wontothree/cart-pole/README.md

# Propopropositional Integral Derivative and Nonlinear Model Predictive Control in Cart Pole

## Sinulation Result

cart_pole

time-response

## Physical Result

Watch the video (https://www.youtube.com/shorts/Vz5JtkAQwwo)

# Physical Specifications

- mass of cart : 0.123 kg (122.61g)
- length of cart : 0.045m (4.5cm)
- mass of pole : 0.089 kg (88.68g)
- length of pole : 0.4m (40cm)
- inertia of pole : 0.004 746 kg m^2
- length of rail (linear guide) : 0.72m (72cm)
- maximum magnitude of force : 1.2 N

## Materials

|Name|Product|Price|
|---|---|---|
|Stepper Motor|[KH42JM2-901](https://www.devicemart.co.kr/goods/view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)|27,000 won|
|Stepper Motor Driver|[AM-CS2P](https://www.devicemart.co.kr/goods/view?no=6773)|25,000 won|
|Absolute Rotary Encoder|[EN25-Absolute](https://www.devicemart.co.kr/goods/view?no=15454627)|75,000 won|
|End Stop|[Photo Interrupter Sensor](https://smartstore.naver.com/misoparts/products/5263638196?)|300 won|
|Processor|[Raspberry Pi Pico 1](https://www.devicemart.co.kr/goods/view?no=14021609&src=raspberrypi)|6,400 won|
||||
|Cedar Wooden plank||28,000 won|
|Linear Guide||45,913 won|
|Wooden Rod||2,800 won|
|Shaft Holder||7,260 won|
|Timing Pulley||1,500 won|
|Timing Idler||900 won|
|Timing Belt||1,412 won|
|||
|Sheet Metal (Aluminum)||130,000 won|
