wontothree/cart-pole/firmware/README.md

# Getting Started

contact devcontainer

```bash
build
```

boot and rest Raspberry Pi Pico

copy and paste 'stepper_control.uf2' in build to 'RPI-RP2'
