wontothree/cart-pole/control/README.md

# Nonlinear Model Predictive Control vs Deep Reinforcement Learning

[Nonlinear Model Predictive Control](https://wontothree.github.io/cartpole/mpc/)

# Control Sampling Period

- Measurement period of rotary absolute encoder : 10ms (100Hz)
- Serial communication period : 8 ~ 15 ms
- Control sampling period : 50ms (20Hz)

# NMPC Dependencies

[CasADi](https://web.casadi.org/)

```bash
pip install casadi
```
