wontothree/cart-pole/3d-modeling/linear_guide_base.step

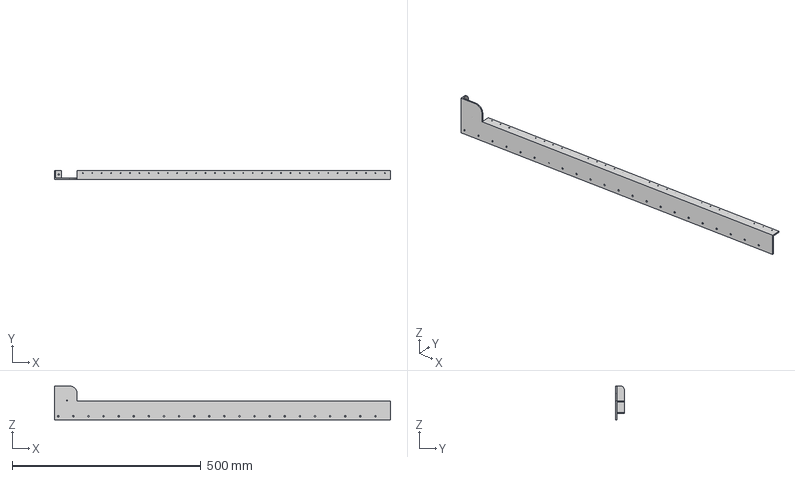
[picture p1: CAD file, 2024-12-08]
3d-modeling/linear_guide_base.step
890.0 x 23.0 x 90.0 mm
