wontothree/cart-pole/3d-modeling/inverted_pendulum.step

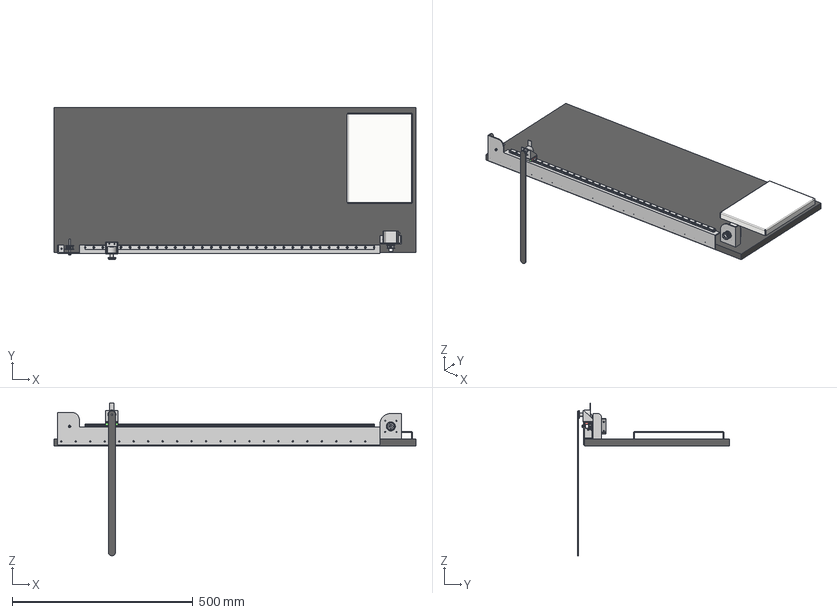
[picture p2: CAD file, 2024-12-08]
3d-modeling/inverted_pendulum.step
1000.0 x 419.6 x 421.5 mm
1000*400_Base
LZE01-MGN12C-800-N-Z0_1
LZE01-MGN12C-N-Z0_2
빵판
linear_guide_base
motor_bracket
stepper_motor
wood_stick
30T_timing_pulley
M4x40
30T_timing_idler
encoder_bracket
rotary_encoder
shaft_coupler
endstop_slot
