wontothree/cart-pole/3d-modeling/motor_bracket.step

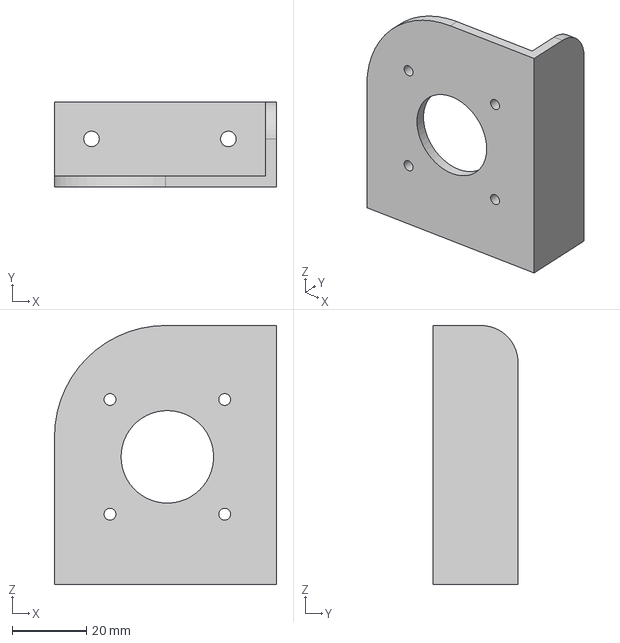
[picture p3: CAD file, 2024-12-08]
3d-modeling/motor_bracket.step
60.0 x 23.0 x 70.0 mm
