wontothree/cart-pole/(list of files, cad)

Other CAD files:
3d-modeling/linear_guide_base.dwg
3d-modeling/linear_guide_base.dxf
3d-modeling/motor_bracket.dwg
3d-modeling/motor_bracket.dxf
