wontothree/cart-pole/control/nmpc/cartpole_nmpc_ver3.py

import numpy as np
import casadi
import matplotlib.pyplot as plt

from mpc import MPC

class CartPoleNMPC(MPC):
    def __init__(self):
        super().__init__(state_dim=4, control_dim=1, prediction_horizon=20, control_sampling_time=0.1)

        # System parameters
        self.gravity = 9.81
        self.cart_mass = 0.123
        self.pole_mass = 0.089
        self.pole_length = 0.4

        # State and control variables
        self.state = casadi.SX.sym("state", self.state_dim)
        self.control = casadi.SX.sym("control", self.control_dim)

        # Cost function weights
        self.Q = casadi.diag([1, 10, 0.0001, 0.0001])
        self.Q_f = casadi.diag([1, 10, 0.0001, 0.0001])
        self.R = casadi.diag([0.1])

        # Constraints
        self.state_lower_bound = [-0.36, -np.inf, -np.inf, -np.inf]
        self.state_upper_bound = [0.36, np.inf, np.inf, np.inf]
        self.control_lower_bound = [-10]
        self.control_upper_bound = [10]

        # number of optimization variables
        self.total_variables = (self.prediction_horizon + 1) * self.state_dim + self.prediction_horizon * self.control_dim

    def define_dynamic_model(self):
        # constant parameter
        g = self.gravity
        M = self.cart_mass
        m = self.pole_mass
        L = self.pole_length

        # state variables
        x = self.state[0]
        theta = self.state[1]
        x_dot = self.state[2]
        theta_dot = self.state[3]

        # control input variable
        F = self.control[0]

        sin = casadi.sin(theta)
        cos = casadi.cos(theta)
        common = M + m * sin**2

        # dynamics
        x_ddot = (m * g * sin * cos - m * L / 2 * sin * theta_dot**2 + F) / common
        theta_ddot = (- m * L / 2 * sin * cos * theta_dot**2 + (M + m) * g * sin + F * cos) / (L / 2 * common)

        states_dot = casadi.vertcat(x_dot, theta_dot, x_ddot, theta_ddot)

        continuous_dynamic_model = casadi.Function("f", [self.state, self.control], [states_dot], ['x', 'u'], ['x_dot'])

        # discretize
        r1 = continuous_dynamic_model(x=self.state, u=self.control)["x_dot"]
        r2 = continuous_dynamic_model(x=self.state + self.control_sampling_time * r1 / 2, u=self.control)["x_dot"]
        r3 = continuous_dynamic_model(x=self.state + self.control_sampling_time * r2 / 2, u=self.control)["x_dot"]
        r4 = continuous_dynamic_model(x=self.state + self.control_sampling_time * r3, u=self.control)["x_dot"]

        states_next = self.state + self.control_sampling_time * (r1 + 2 * r2 + 2 * r3 + r4) / 6

        discretized_dynamic_model = casadi.Function("discretied_dynamic_model", [self.state, self.control], [states_next], ["x", "u"], ["x_next"])

        return discretized_dynamic_model
    
    def define_constraint(self, state_trajectory, control_trajectory, current_state):
        discretized_dynamic_model = self.define_dynamic_model()
        # equality constraint
        equality_constraint_lower_bound = [0] * (self.prediction_horizon * self.state_dim)
        equality_constraint_upper_bound = [0] * (self.prediction_horizon * self.state_dim)
        equality_constraint = []
        for step in range(self.prediction_horizon):
            predicted_next_state = discretized_dynamic_model(x = state_trajectory[step], u = control_trajectory[step])["x_next"]
            constraint = state_trajectory[step  + 1] - predicted_next_state
            equality_constraint.append(constraint)
        
        # inequality constraint
        current_state = current_state.full().ravel().tolist()
        optimization_variable_lower_bound = current_state + self.prediction_horizon * self.state_lower_bound + self.prediction_horizon * self.control_lower_bound
        optimization_variable_upper_bound = current_state + self.prediction_horizon * self.state_upper_bound + self.prediction_horizon * self.control_upper_bound

        return equality_constraint, equality_constraint_lower_bound, equality_constraint_upper_bound, optimization_variable_lower_bound, optimization_variable_upper_bound

    # cost for one state and control input
    def define_cost_function(self, state_trajectory, control_trajectory):
        """
        - state_trajectory : vector having dimension (prediction_horizon + 1)
        - control_trajectory : vector having dimention (prediction_horizon)
        """
        cost = 0
        state_cost = 0
        terminal_cost = 0

        # state cost
        for step in range(self.prediction_horizon):
            state_error = state_trajectory[step] - self.reference_state
            control_error = control_trajectory[step] - self.reference_control

            state_step_cost = (casadi.dot(self.Q @ state_error, state_error) + casadi.dot(self.R @ control_error, control_error)) / 2

            state_cost += state_step_cost * self.control_sampling_time
        
        # terminal cost
        state_error = state_trajectory[-1] - self.reference_state
        terminal_cost = casadi.dot(self.Q_f @ state_error, state_error)

        cost = state_cost + terminal_cost

        return cost

    def solve(self, current_state):
        state_trajectory = [casadi.SX.sym(f"x_{k}", self.state_dim) for k in range(self.prediction_horizon + 1)]
        control_trajectory = [casadi.SX.sym(f"u_{k}", self.control_dim) for k in range(self.prediction_horizon)]

        # cost function
        cost_function = self.define_cost_function(state_trajectory, control_trajectory)

        # equality constraint and inequality constraint
        equality_constraint, equality_constraint_lower_bound, equality_constraint_upper_bound, optimization_variable_lower_bound, optimization_variable_upper_bound = \
            self.define_constraint(state_trajectory, control_trajectory, current_state)
        
        # set up the NLP problem
        nonlinear_programming_problem = {
            "x": casadi.vertcat(*state_trajectory, *control_trajectory),
            "f": cost_function,
            "g": casadi.vertcat(*equality_constraint)
        }

        # solver options
        options = {
            "print_time": True,
            "ipopt": {
                "max_iter": 1000,
                "print_level": 1
            }
        }

        # create the solver
        solver = casadi.nlpsol("solver", "ipopt", nonlinear_programming_problem, options)

        initial_guess = casadi.DM.zeros(self.total_variables)

        # solve the optimization problem
        optimization_problem_solving_result = solver(
            x0 = initial_guess,
            lbx = optimization_variable_lower_bound,
            ubx = optimization_variable_upper_bound,
            lbg = equality_constraint_lower_bound,
            ubg = equality_constraint_upper_bound
        )

        # extract the optimal state and control trajectory
        optimization_problem_solution = optimization_problem_solving_result["x"]

        control_start_index = (self.prediction_horizon + 1) * self.state_dim
        optimal_state_trajectory = optimization_problem_solution[:control_start_index].reshape((self.prediction_horizon + 1, self.state_dim)).toarray()
        optimal_control_trajectory = optimization_problem_solution[control_start_index:].reshape((self.prediction_horizon, self.control_dim)).toarray()

        return optimal_state_trajectory, optimal_control_trajectory

    def simulate(self, current_state, time_span):
        time_steps = np.arange(time_span[0], time_span[1], self.control_sampling_time)

        # ...
        I = self.make_integrator()
        
        actual_state_trajectory = [current_state.full().ravel()]
        actual_control_trajectory = []

        for time_step in time_steps:
            optimal_state_trajectory, optimal_control_trajectory = self.solve(current_state)

            current_state = I(x0=current_state, p=optimal_control_trajectory[0])["xf"]

            # 센서로부터 얻은 actual_state_trajectory를 저장해야 한다.
            # actual_state_trajectory.append(optimal_state_trajectory[0])
            actual_state_trajectory.append(current_state.full().ravel())
            actual_control_trajectory.append(optimal_control_trajectory[0])

        actual_state_trajectory.pop()

        return actual_state_trajectory, actual_control_trajectory, time_steps
    
    def visualize(self, actual_state_trajectory, actual_control_trajectory, time_steps):
        # Convert state and control trajectories to NumPy arrays
        actual_state_trajectory = np.array(actual_state_trajectory)
        actual_control_trajectory = np.array(actual_control_trajectory)
         
        # Ensure time_steps is a NumPy array
        time_steps = np.array(time_steps)
        
        # Plot states
        plt.figure(figsize=(12, 6))
        
        plt.subplot(1, 2, 1)
        for k in range(self.state_dim):
            plt.plot(time_steps[:len(actual_state_trajectory)], actual_state_trajectory[:, k], label=f"x_{k}")
        plt.legend()
        plt.xlabel("Time")
        plt.ylabel("State")
        plt.title("State Trajectories")
        
        # Plot controls
        plt.subplot(1, 2, 2)
        for k in range(self.control_dim):
            plt.step(time_steps[:len(actual_control_trajectory)], actual_control_trajectory[:, k], linestyle="--", label=f"u_{k}")
        plt.legend()
        plt.xlabel("Time")
        plt.ylabel("Control")
        plt.title("Control Trajectories")

        plt.tight_layout()
        plt.show()

    def make_f(self):
        # constant parameter
        g = self.gravity
        M = self.cart_mass
        m = self.pole_mass
        L = self.pole_length

        # state variables
        x = self.state[0]
        theta = self.state[1]
        x_dot = self.state[2]
        theta_dot = self.state[3]

        # control input variable
        F = self.control[0]

        sin = casadi.sin(theta)
        cos = casadi.cos(theta)
        common = M + m * sin**2

        # dynamics
        x_ddot = (m * g * sin * cos - m * L / 2 * sin * theta_dot**2 + F) / common
        theta_ddot = (- m * L / 2 * sin * cos * theta_dot**2 + (M + m) * g * sin + F * cos) / (L / 2 * common)

        states_dot = casadi.vertcat(x_dot, theta_dot, x_ddot, theta_ddot)

        continuous_dynamic_model = casadi.Function("f", [self.state, self.control], [states_dot], ['x', 'u'], ['x_dot'])

        return continuous_dynamic_model

    def make_integrator(self):
        # Integrator
        states = casadi.SX.sym("states", self.state_dim)
        ctrls = casadi.SX.sym("ctrls", self.control_dim)

        f = self.make_f()
        ode = f(x=states, u=ctrls)["x_dot"]

        dae = {"x": states, "p": ctrls, "ode": ode}

        I = casadi.integrator("I", "cvodes", dae, 0, self.control_sampling_time)

        return I

if __name__ == "__main__":
    cart_pole_nmpc = CartPoleNMPC()

    cart_pole_nmpc.set_reference_state(casadi.DM([0, 0, 0, 0]))
    cart_pole_nmpc.set_reference_control(casadi.DM([0]))

    # # 초기 상태 설정
    # current_state = np.array([0.2, 0.0, 0.0, 0.0])  # 예: [x, theta, x_dot, theta_dot]

    current_state = casadi.DM([0, np.pi, 0, 0])
    
    actual_state_trajectory, actual_control_trajectory, time_steps = cart_pole_nmpc.simulate(current_state, [0, 15])

    cart_pole_nmpc.visualize(actual_state_trajectory, actual_control_trajectory, time_steps)
