wontothree/cart-pole/(commit log)

2024-09-06 remove gym simulation
    [ant.xml, half_cheetah.xml, hopper.xml, humanoid.xml, humanoidstandup.xml, inverted_double_pendulum.xml, inverted_pendulum.xml, point.xml]
2024-09-11 add stepping motor ver6
2024-09-15 motor driver uart comminication
2024-09-19 feat : uart
2024-09-20 motor controller
2024-09-22 Implement homing
2024-09-22 feat : photo sensor
2024-09-25 add pid controller
2024-09-25 add pid
2024-09-25 add raspberypi pico
2024-09-25 add receiver of encoder data
2024-09-25 feat : encoder uart
2024-09-26 feat : receiving encoder data
2024-09-26 Resolve number type error
    [main.c]
2024-09-26 Fix UART/serial error
2024-12-08 add cad file
    [inverted_pendulum.step, linear_guide_base.dwg, linear_guide_base.dxf, linear_guide_base.step, motor_bracket.dwg, motor_bracket.dxf, motor_bracket.step]
